ignacyr/autonomous-solar-tracker/README.md

# Autonomiczny Tracker Solarny - praca inżynierska (bachelor thesis)
