ignacyr/autonomous-solar-tracker/prezentacja_obrona_IgnacyRogatty.pdf

# AUTONOMICZNY TRACKER SOLARNY

# Ignacy Rogatty

## Promotor : dr hab. inż. Jacek Rezmer

# - Celem pracy było wykonanie systemu podążającego za słońcem (trackera solarnego) na mikrokontrolerze

i silnikach elektrycznych.

# - Zakres pracy obejmował opracowanie koncepcji

urządzenia, | wykonanie | części | mechanicznej

# i elektronicznej urządzenia, utworzenie programu sterującego i komunikacyjnego oraz prowadzenie

testów i analizę działania systemu.

# CEL I ZAKRES PRACY

# RODZAJE TRACKERÓW SOLARNYCH

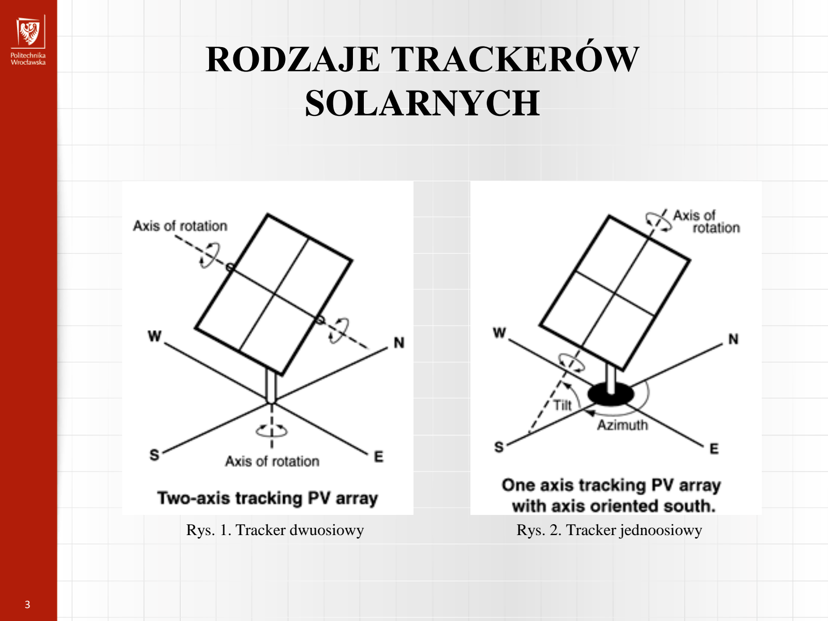
[picture p27: page 3]

Rys. 1. Tracker dwuosiowy | Rys. 2. Tracker jednoosiowy

# TRACKER SOLARNY JEDNOOSIOWY POCHYLONY

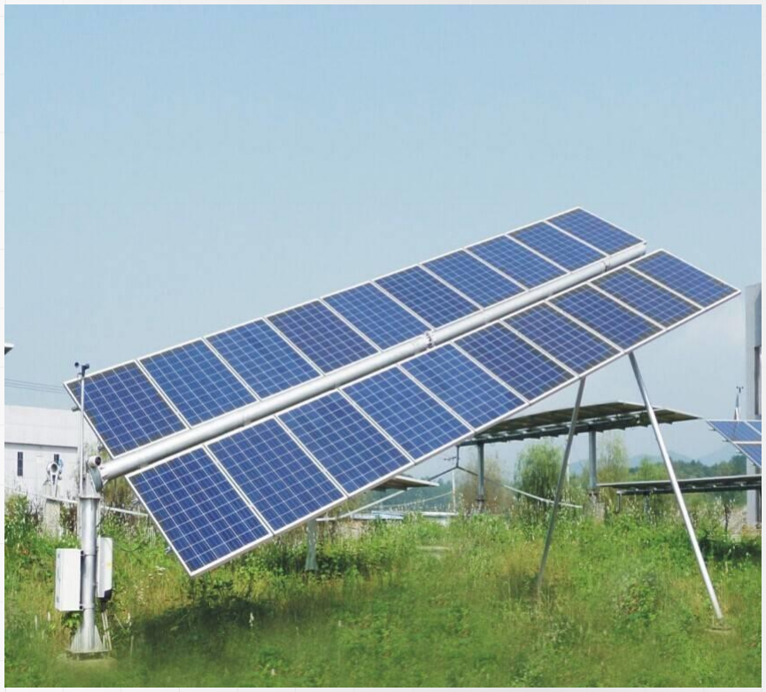
[picture p28: figure]

Rys. 3. Chiński tracker jednoosiowy pochylony

# KĄT AZYMUTU I ELEWACJI

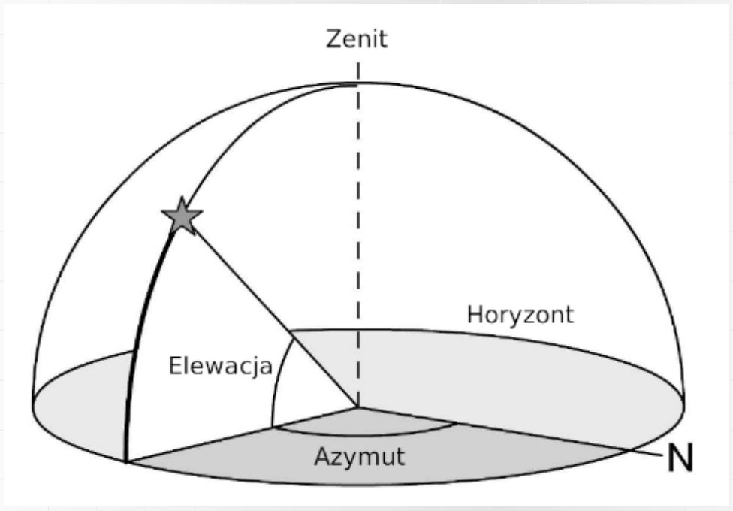
[picture p29: figure]

Rys. 4. Wizualizacja kątów azymutu i elewacji, oraz horyzontu i zenitu

# ZAŁOŻENIA PROJEKTOWE

## - Budowa prototypu trackera solarnego jednoosiowego pochylonego wraz z panelem stałym

jako punkt odniesienia.

## - Możliwość manualnej regulacji kąta nachylenia

trackera na przestrzeni roku.

## - Przeprowadzenie badań prototypu, które udowodnią tezę, że tracker jednoosiowy pochylony jest w stanie wyprodukować zbliżoną ilość energii do trackera dwuosiowego przy zmniejszonych kosztach

inwestycji.

# KONSTRUKCJA

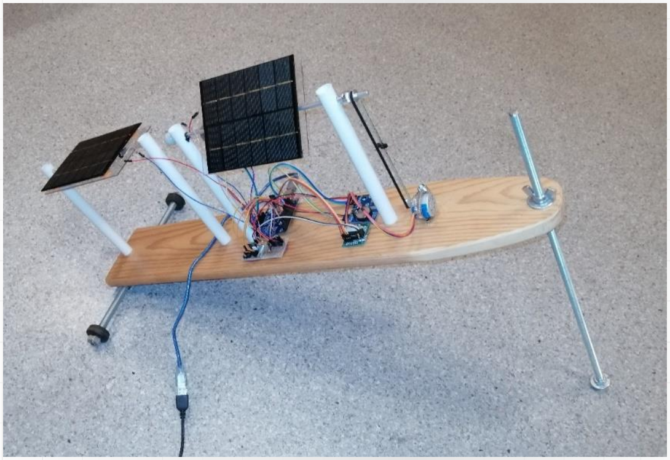
[picture p30: figure]

Rys. 5. Konstrukcja prototypu trackera jednoosiowego pochylonego

# ELEKTRONIKA

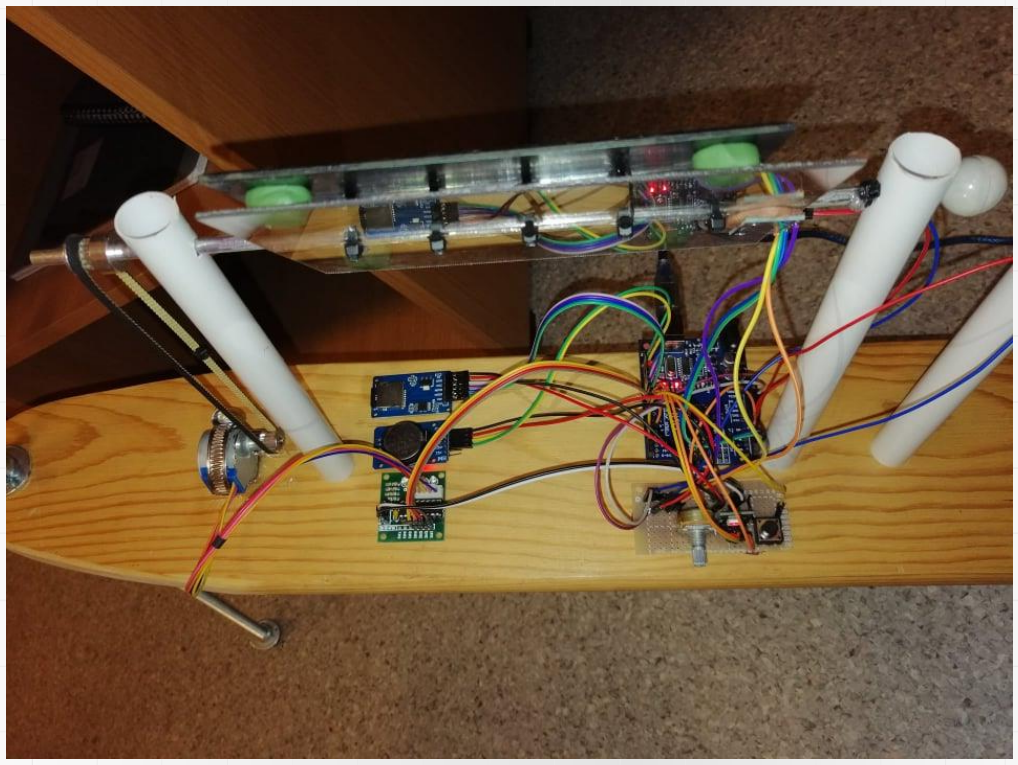
[picture p31: figure]

Rys. 6. Elementy elektroniczne prototypu trackera jednoosiowego pochylonego

# PROGRAM ARDUINO

- Pomiar napięcia na zaciskach paneli fotowoltaicznych.
- Pomiar kątów nachylenia trackera w dwóch osiach, przeliczanie ich na kąty azymutu i elewacji.

## - Obliczanie pozycji Słońca na niebie na podstawie lokalizacji

trackera i czasu UTC.

## - Przesyłanie tych danych do komputera PC poprzez port

szeregowy oraz zapis na kartę MicroSD.
- 3 tryby wybierane przyciskiem (manualny, automatyczny, testowy).

## - Regulacja dwupołożeniowa kąta azymutu i elewacji trackera

za pomocą silnika krokowego.

# TESTY PROGRAMU

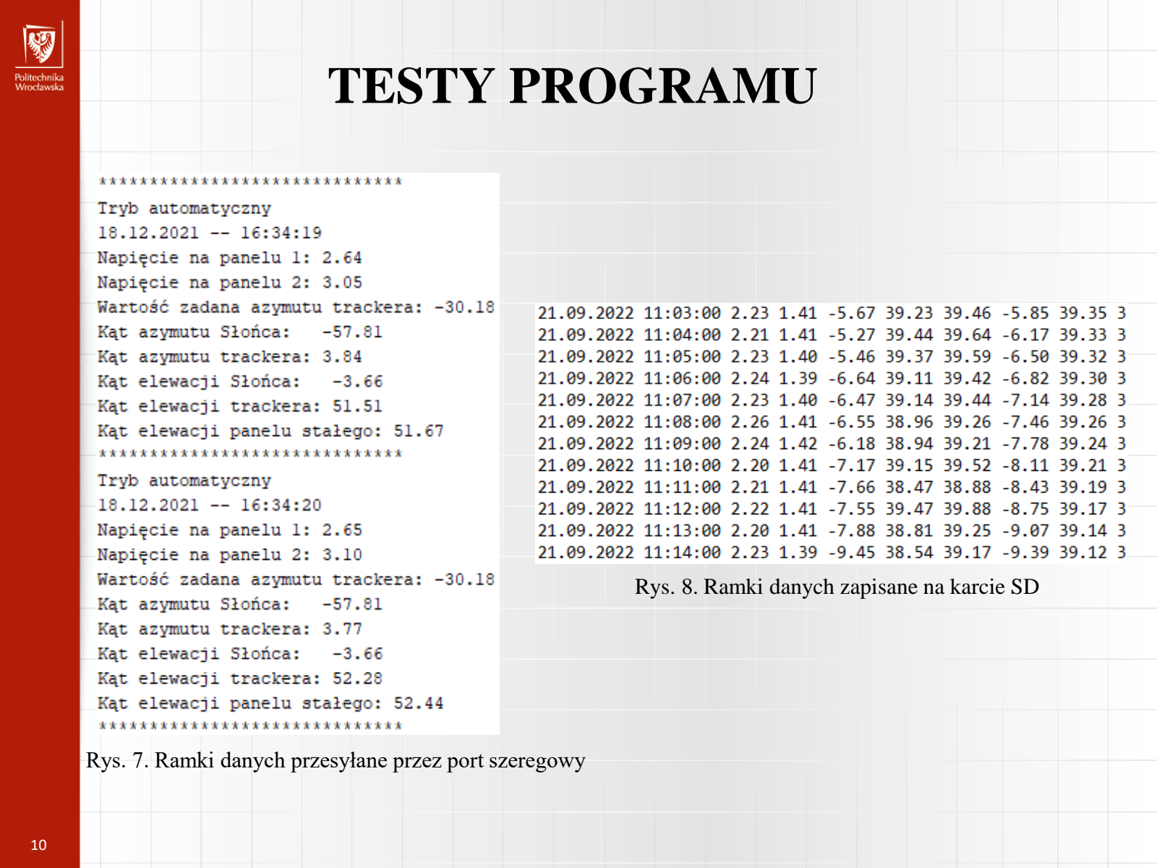
[picture p32: page 10]

Rys. 7. Ramki danych przesyłane przez port szeregowy

Rys. 8. Ramki danych zapisane na karcie SD

# BADANIE OPTYMALNEGO KĄTA NACHYLENIA

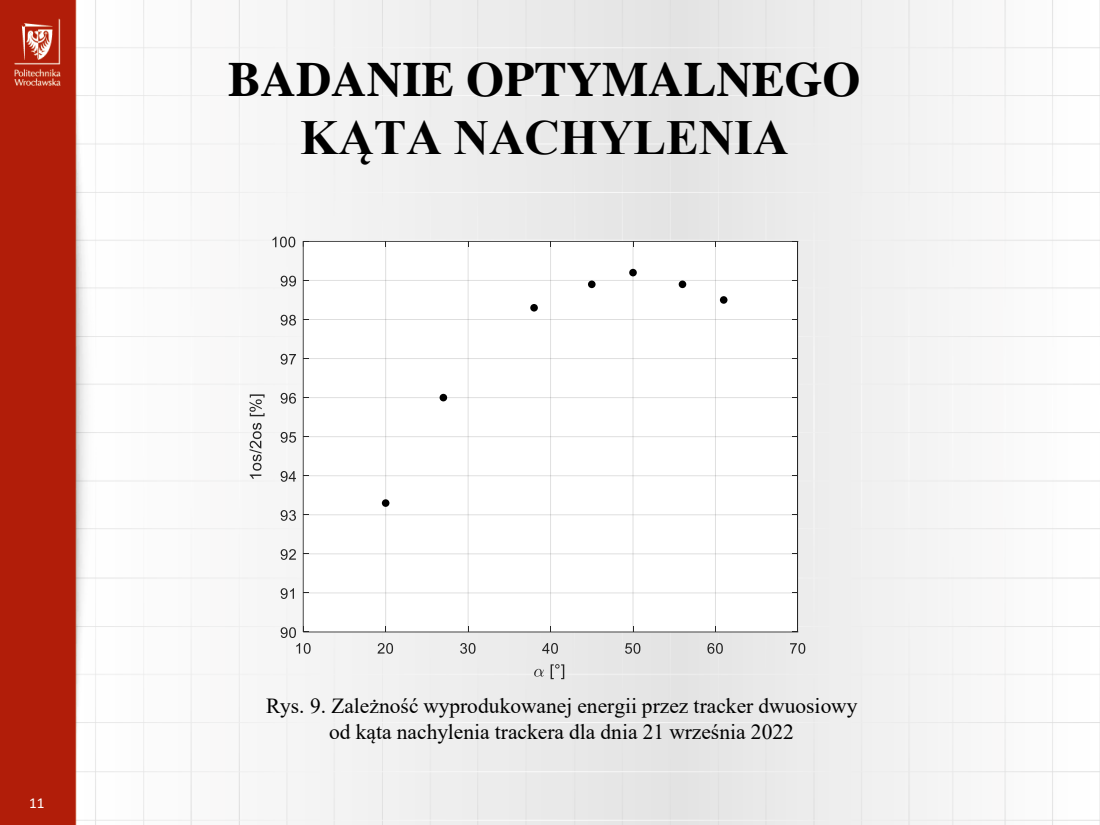
[picture p33: page 11]

Rys. 9. Zależność wyprodukowanej energii przez tracker dwuosiowy

od kąta nachylenia trackera dla dnia 21 września 2022

# BADANIA PRODUKCJI ENERGII

## - Napisano skrypt Matlab’a obliczający teoretyczną

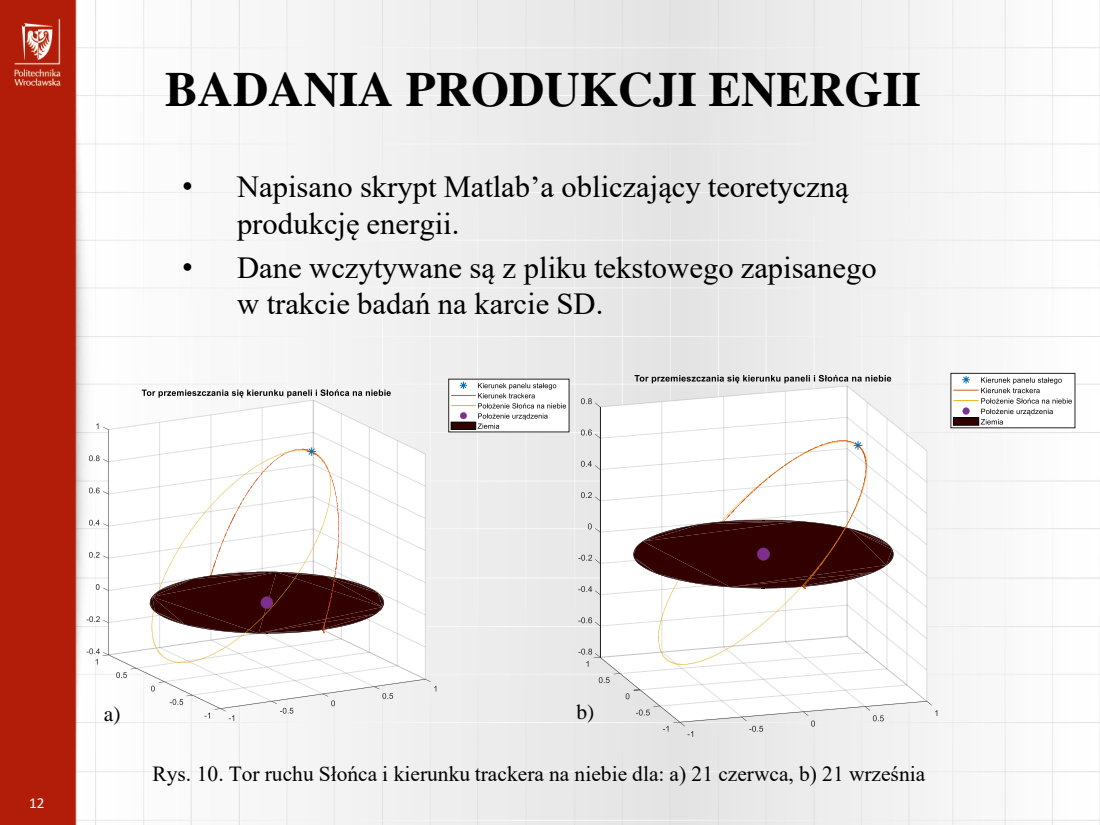
[picture p34: page 12]

produkcję energii.
• Dane wczytywane są z pliku tekstowego zapisanego
w trakcie badań na karcie SD.

Rys. 10. Tor ruchu Słońca i kierunku trackera na niebie dla: a) 21 czerwca, b) 21 września

# BADANIE PRODUKCJI – LATO

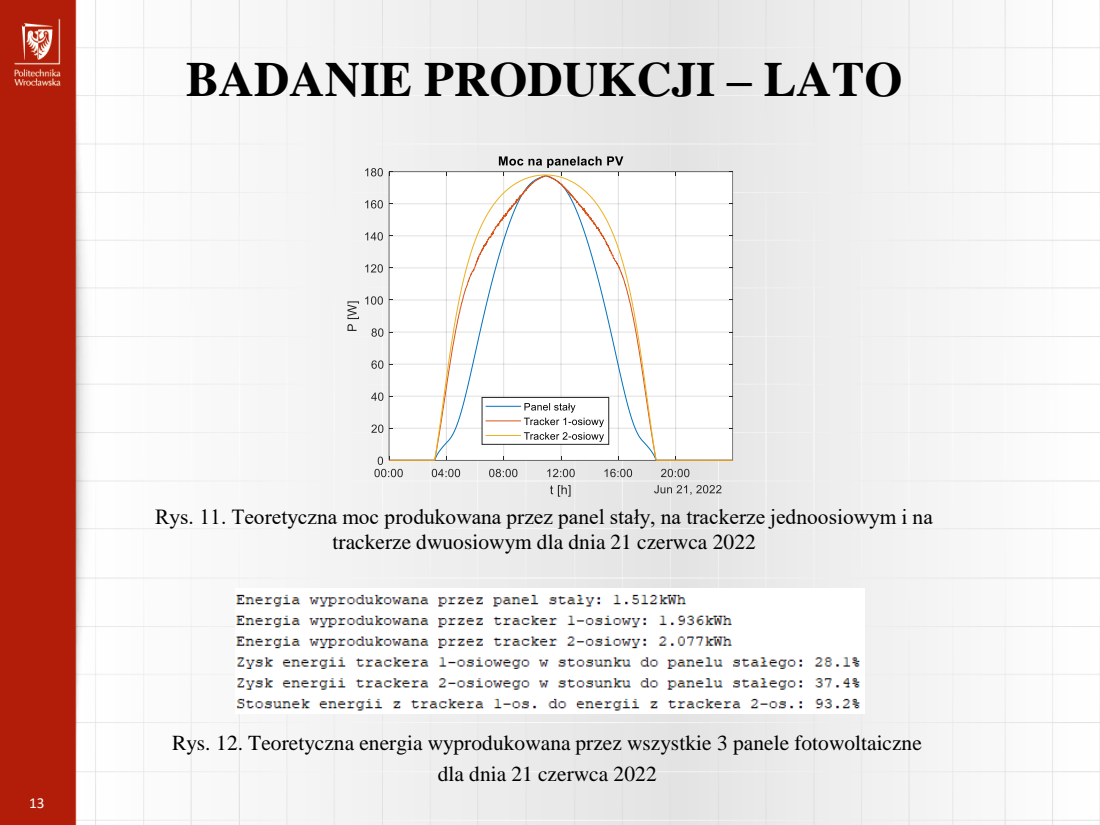
[picture p35: page 13]

Rys. 11. Teoretyczna moc produkowana przez panel stały, na trackerze jednoosiowym i na

trackerze dwuosiowym dla dnia 21 czerwca 2022

Rys. 12. Teoretyczna energia wyprodukowana przez wszystkie 3 panele fotowoltaiczne

dla dnia 21 czerwca 2022

# BADANIE PRODUKCJI – JESIEŃ

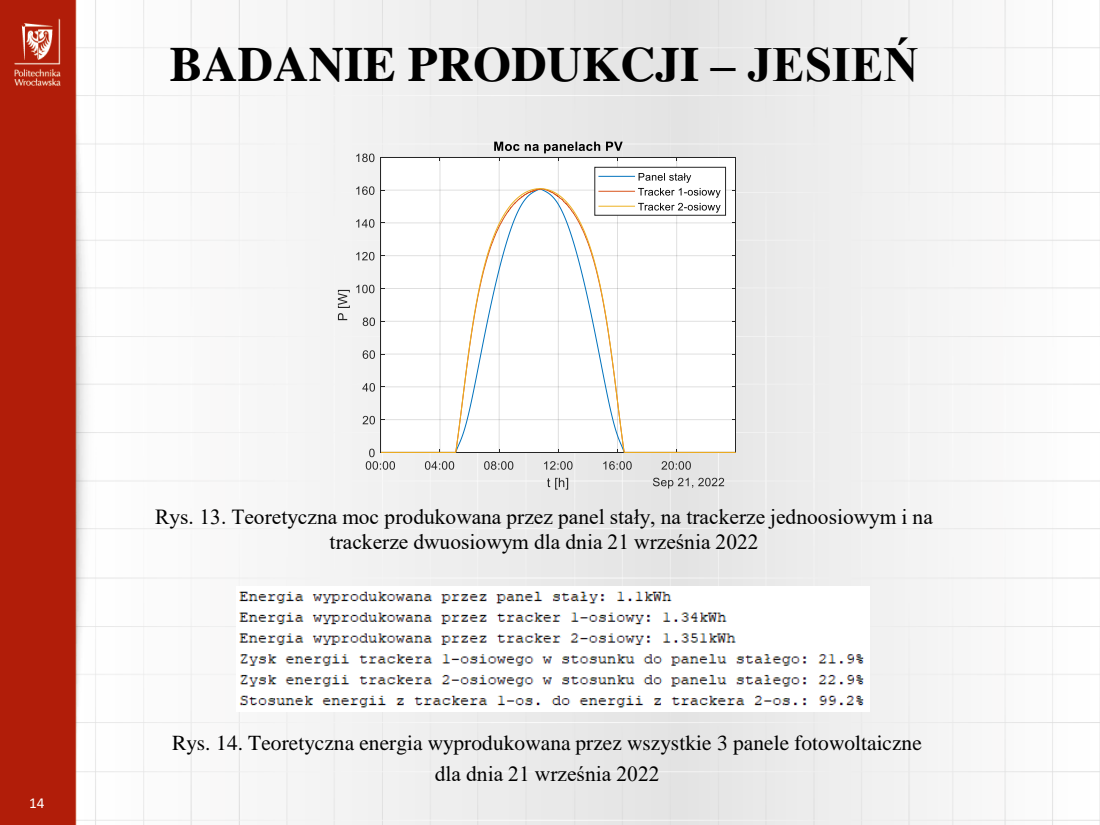
[picture p36: page 14]

Rys. 13. Teoretyczna moc produkowana przez panel stały, na trackerze jednoosiowym i na

trackerze dwuosiowym dla dnia 21 września 2022

Rys. 14. Teoretyczna energia wyprodukowana przez wszystkie 3 panele fotowoltaiczne

dla dnia 21 września 2022

# BADANIE PRODUKCJI – ZIMA

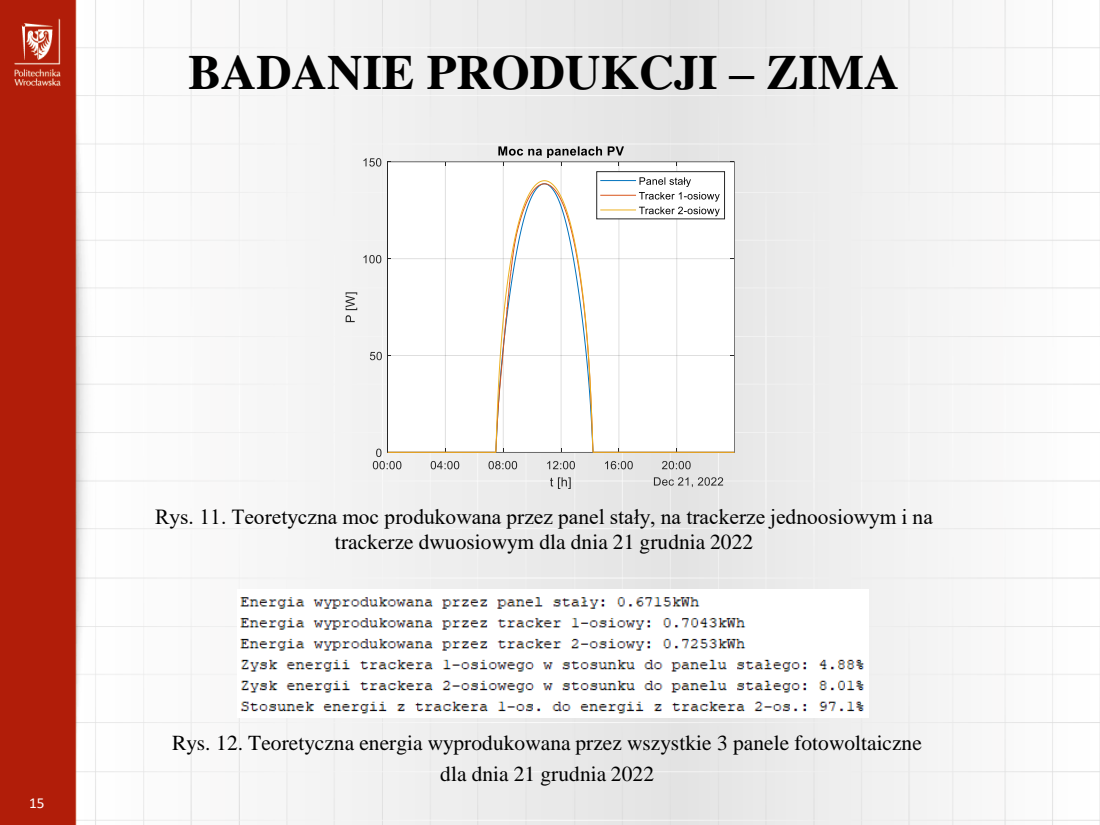
[picture p37: page 15]

Rys. 11. Teoretyczna moc produkowana przez panel stały, na trackerze jednoosiowym i na

trackerze dwuosiowym dla dnia 21 grudnia 2022

Rys. 12. Teoretyczna energia wyprodukowana przez wszystkie 3 panele fotowoltaiczne

dla dnia 21 grudnia 2022

# PODSUMOWANIE

- Z badań wynika, że dla wszystkich trackerów solarnych okres,

## w którym zysk produkcji energii elektrycznej w stosunku do paneli stałych jest największy to okres letni. Najniższy zysk

energii jest w okresie zimowym.

## - W przypadku badanego trackera jednoosiowego pochylonego największą skuteczność śledzenia ruchu Słońca na niebie

uzyskuje się w okolicach przesilenia wiosennego i jesiennego.

## - Cel i zakres pracy zostały zrealizowane, a badania dowiodły, że przy zastosowaniu trackera jednoosiowego pochylonego jest możliwe uzyskanie produkcji energii na bardzo zbliżonym poziomie do trackera dwuosiowego przy zmniejszonych

kosztach inwestycji.

# DZIĘKUJĘ ZA UWAGĘ
